apurbo472/555-Timer-Based-Resistance-Measurement-System-using-Arduino-and-I2C-LCD/Screenshot 2026-09-23 001247.png

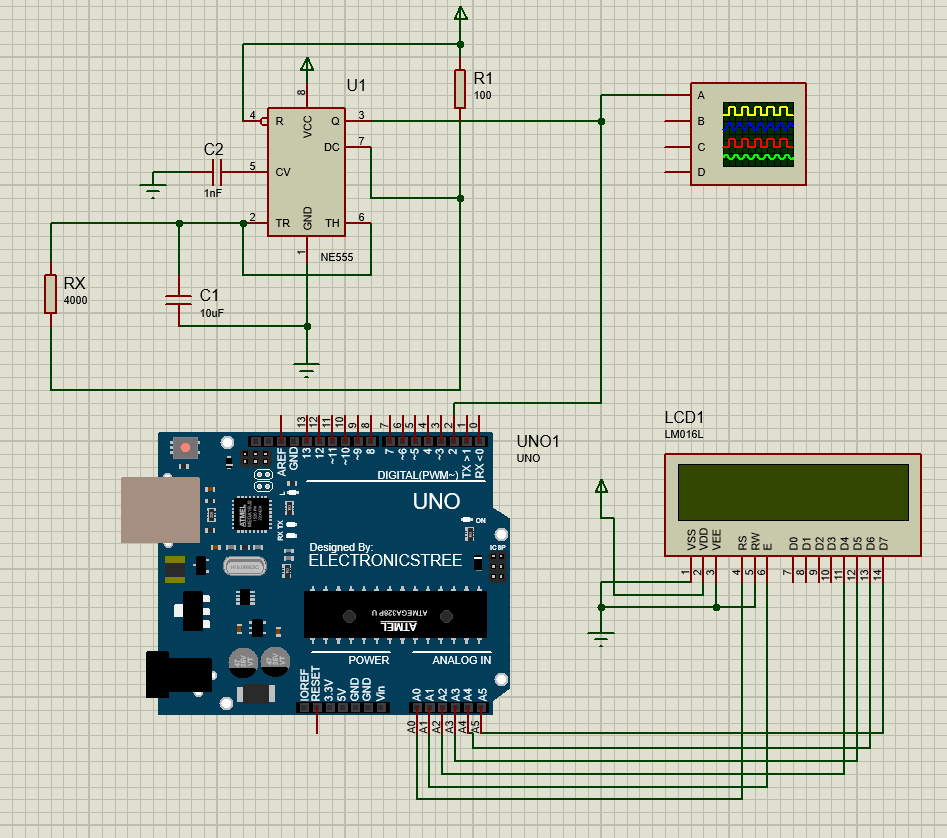
Screenshot 2026-09-23 001247.png
