apurbo472/555-Timer-Based-Resistance-Measurement-System-using-Arduino-and-I2C-LCD/(list of files, drawings)

Other design files:
measurement_2.0.pdsprj
